hughpyle/teensy-povwand/schematic.png

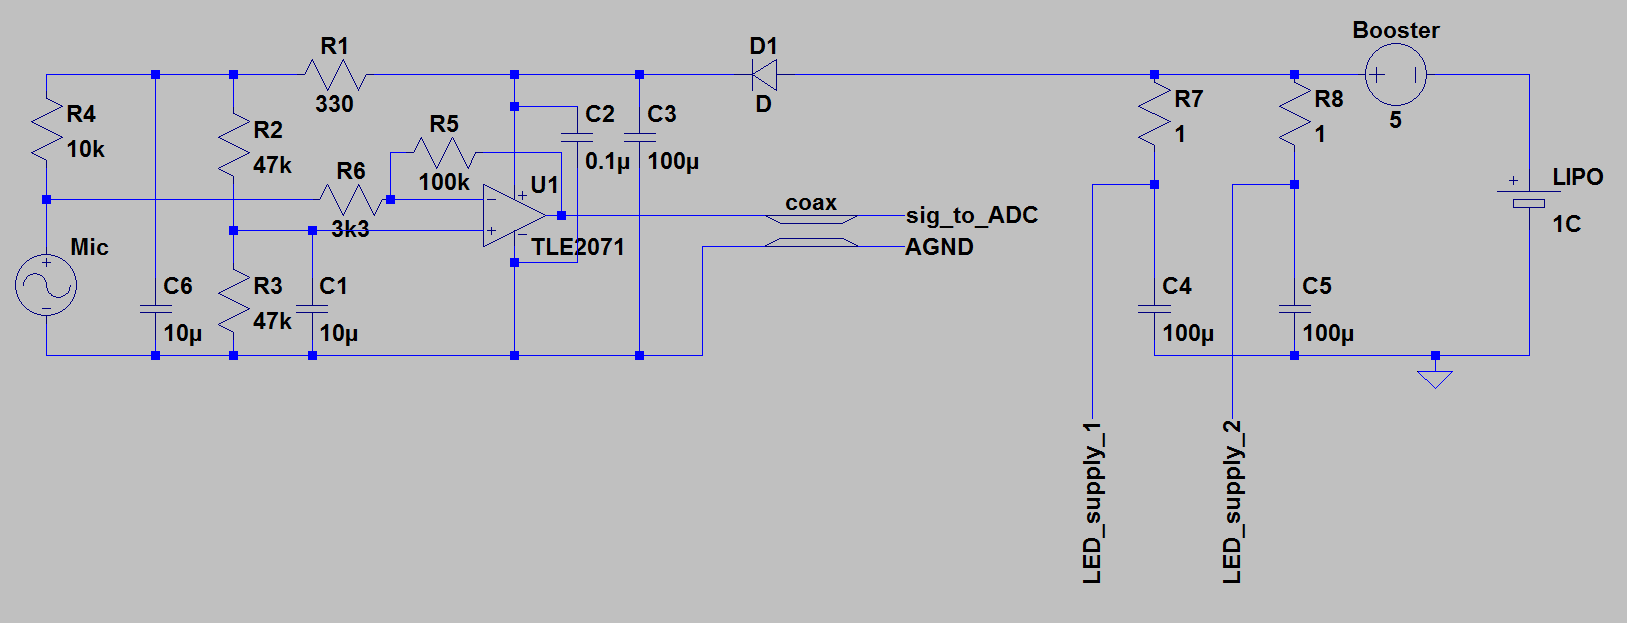
schematic.png
