hughpyle/teensy-povwand/wand1.asc

Booster: voltage; 5
C1: cap; 10µ
C2: cap; 0.1µ
C3: cap; 100µ
C4: cap; 100µ
C5: cap; 100µ
C6: cap; 10µ
coax: tline; ""
D1: diode
LIPO: cell; 1C
Mic: signal; ""
R1: res; 330
R2: res; 47k
R3: res; 47k
R4: res; 10k
R5: res; 100k
R6: res; 3k3
R7: res; 1
R8: res; 1
U1: opamp2; TLE2071
Named nets: sig_to_ADC, 0, AGND, LED_supply_1, LED_supply_2
